davidfriar/the46/case/models/SW_Kailh_Choc_V1.stp

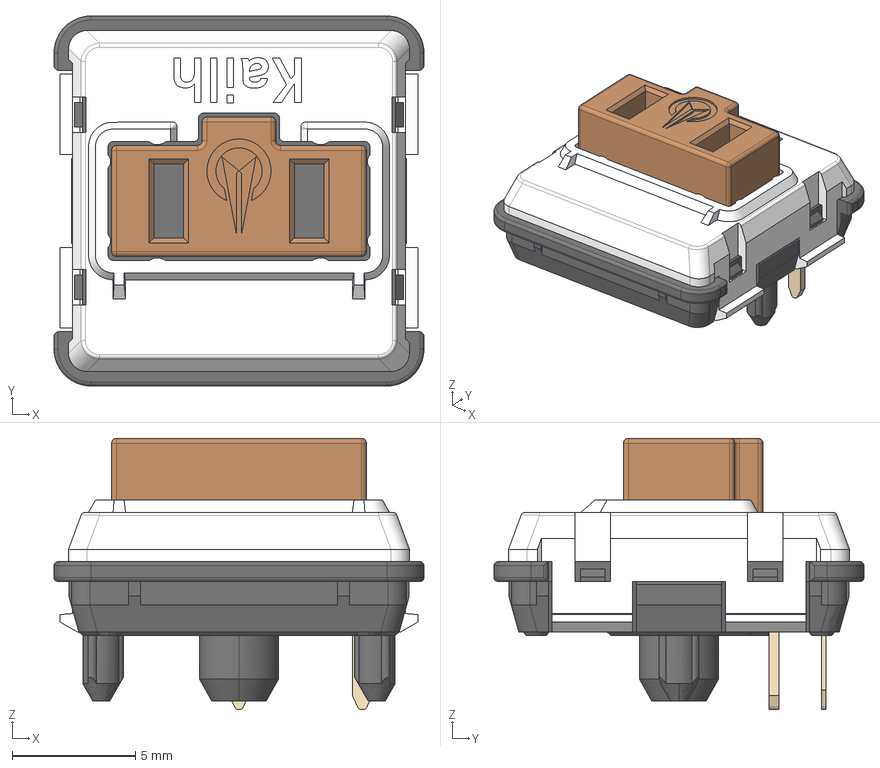
[picture p1: CAD file, 2025-01-09]
case/models/SW_Kailh_Choc_V1.stp
15.0 x 15.0 x 11.0 mm
