davidfriar/the46/ergogen/footprints/niceview.step

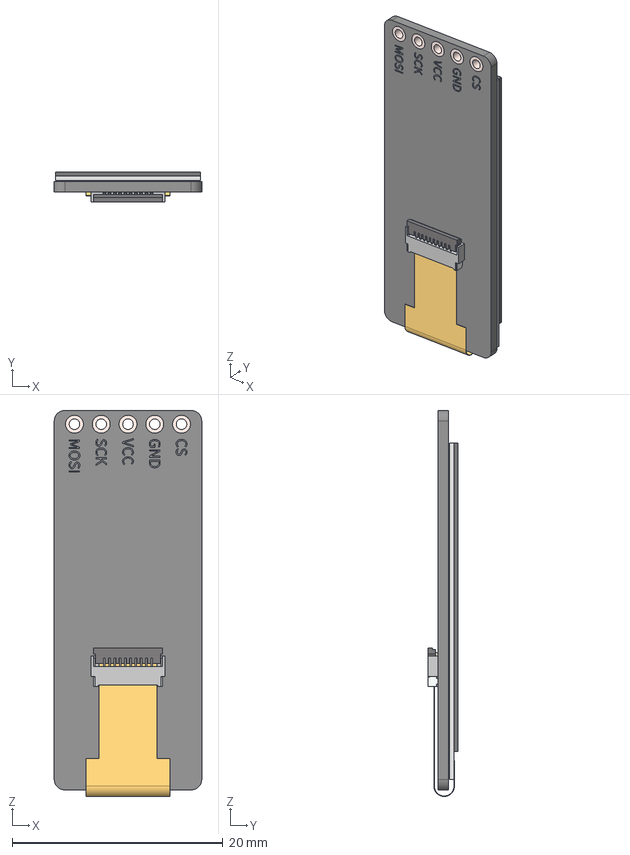
[picture p2: CAD file, 2025-10-15]
ergogen/footprints/niceview.step
14.0 x 2.87 x 36.6 mm
Silkscreen
Screen
FPC
FFC2B28_SP x 2
FFC2B28-10-G_C
FFC2B28-G_P x 10
FFC2B28-10-G_H
FFC2B28-10-G_D
