davidfriar/the46/pcbs/models/S2B-ZR.STEP

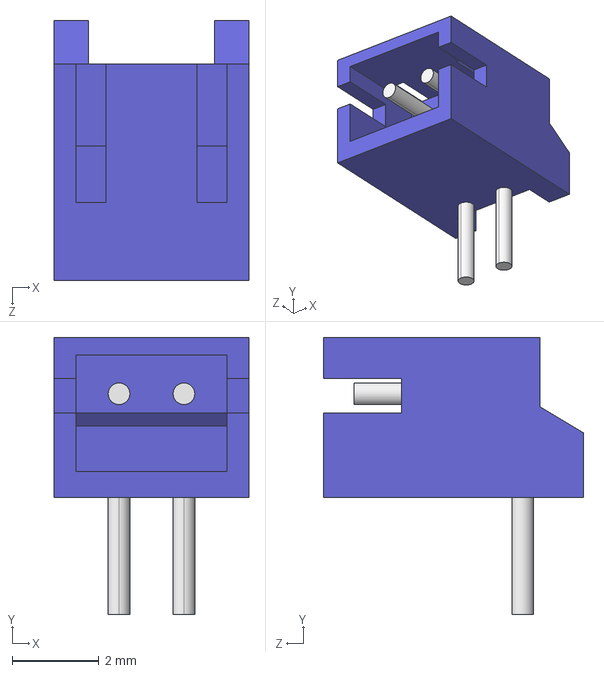
[picture p3: CAD file, 2025-10-15]
pcbs/models/S2B-ZR.STEP
4.50 x 6.40 x 6.00 mm
