davidfriar/the46/ergogen/footprints/FFC2B28-10-G.stp

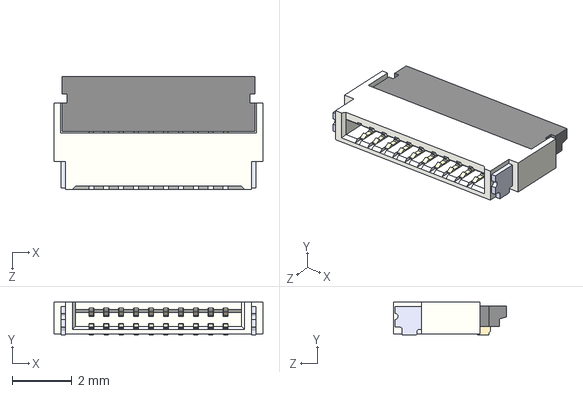
[picture p5: CAD file, 2025-01-09]
ergogen/footprints/FFC2B28-10-G.stp
7.00 x 1.10 x 3.80 mm
