davidfriar/the46/pcbs/models/FFC2B28-12-G.step

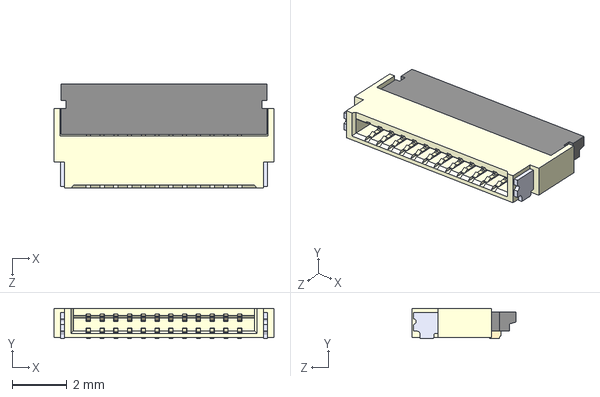
[picture p6: CAD file, 2025-01-09]
pcbs/models/FFC2B28-12-G.step
8.00 x 1.10 x 3.80 mm
