davidfriar/the46/ergogen/footprints/2004850410.stp

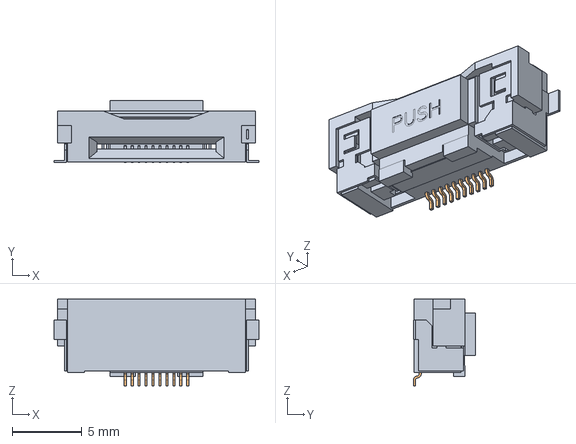
[picture p7: CAD file, 2025-01-09]
ergogen/footprints/2004850410.stp
14.7 x 4.46 x 6.20 mm
