davidfriar/the46/pcbs/models/430471035826_Download_STP_WS-TASV_430471035826_rev1.stp

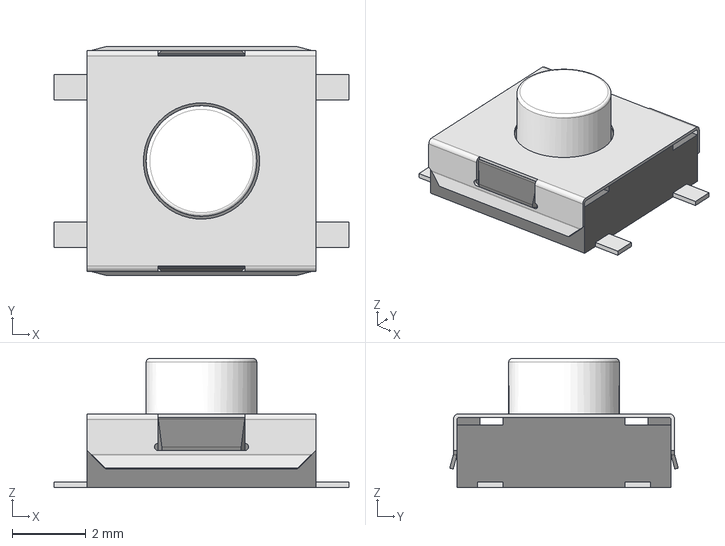
[picture p8: CAD file, 2025-10-15]
pcbs/models/430471035826_Download_STP_WS-TASV_430471035826_rev1.stp
8.00 x 6.20 x 3.50 mm
base
top cover
