davidfriar/the46/pcbs/mainboard/mainboard.kicad_pcb

## KiCad design pcbs/mainboard/mainboard.kicad_pcb (2025-10-22)

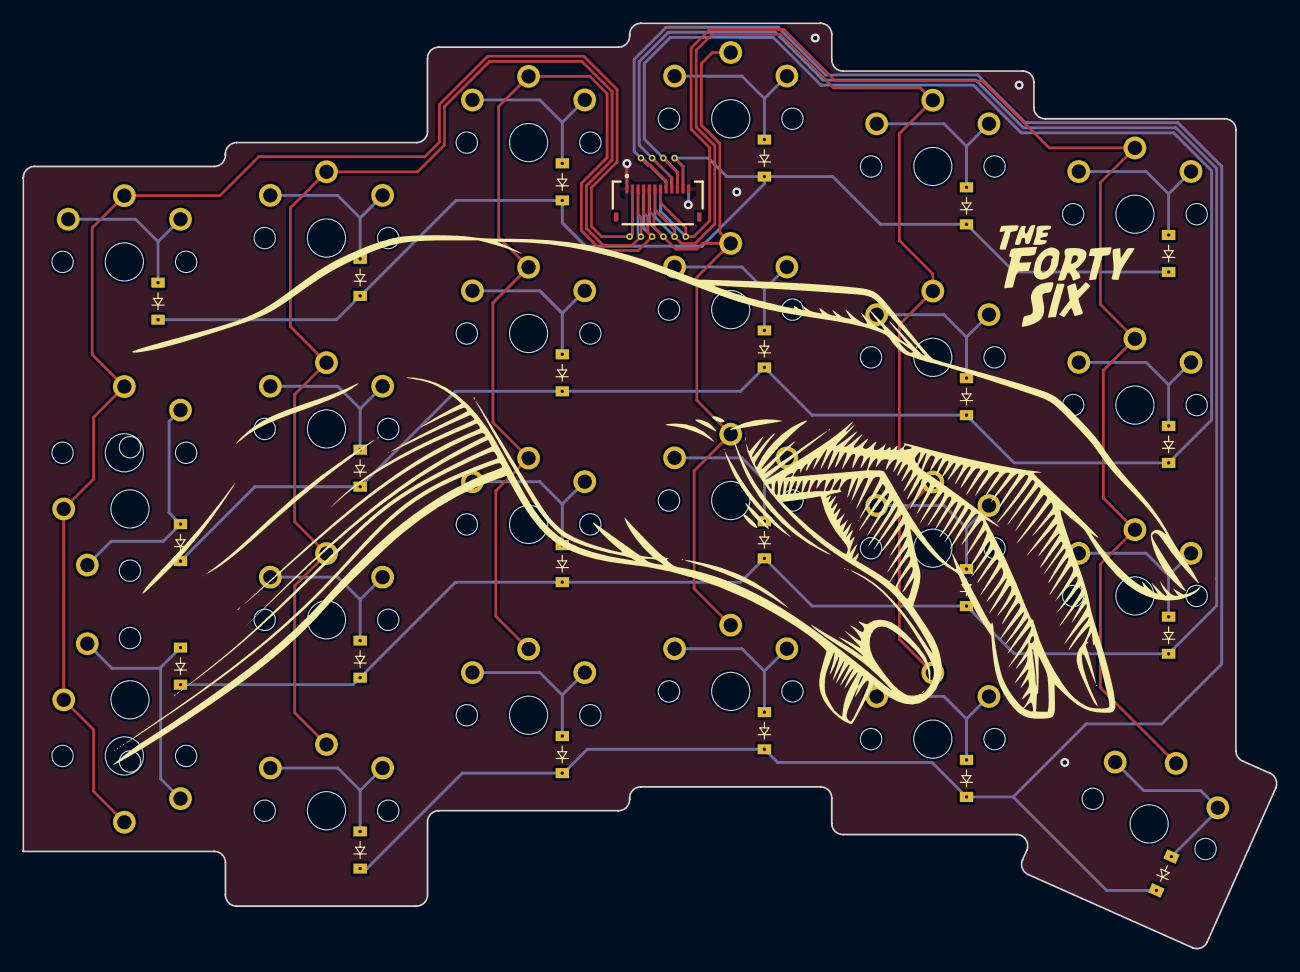
[picture p9: board mainboard.kicad_pcb from above]

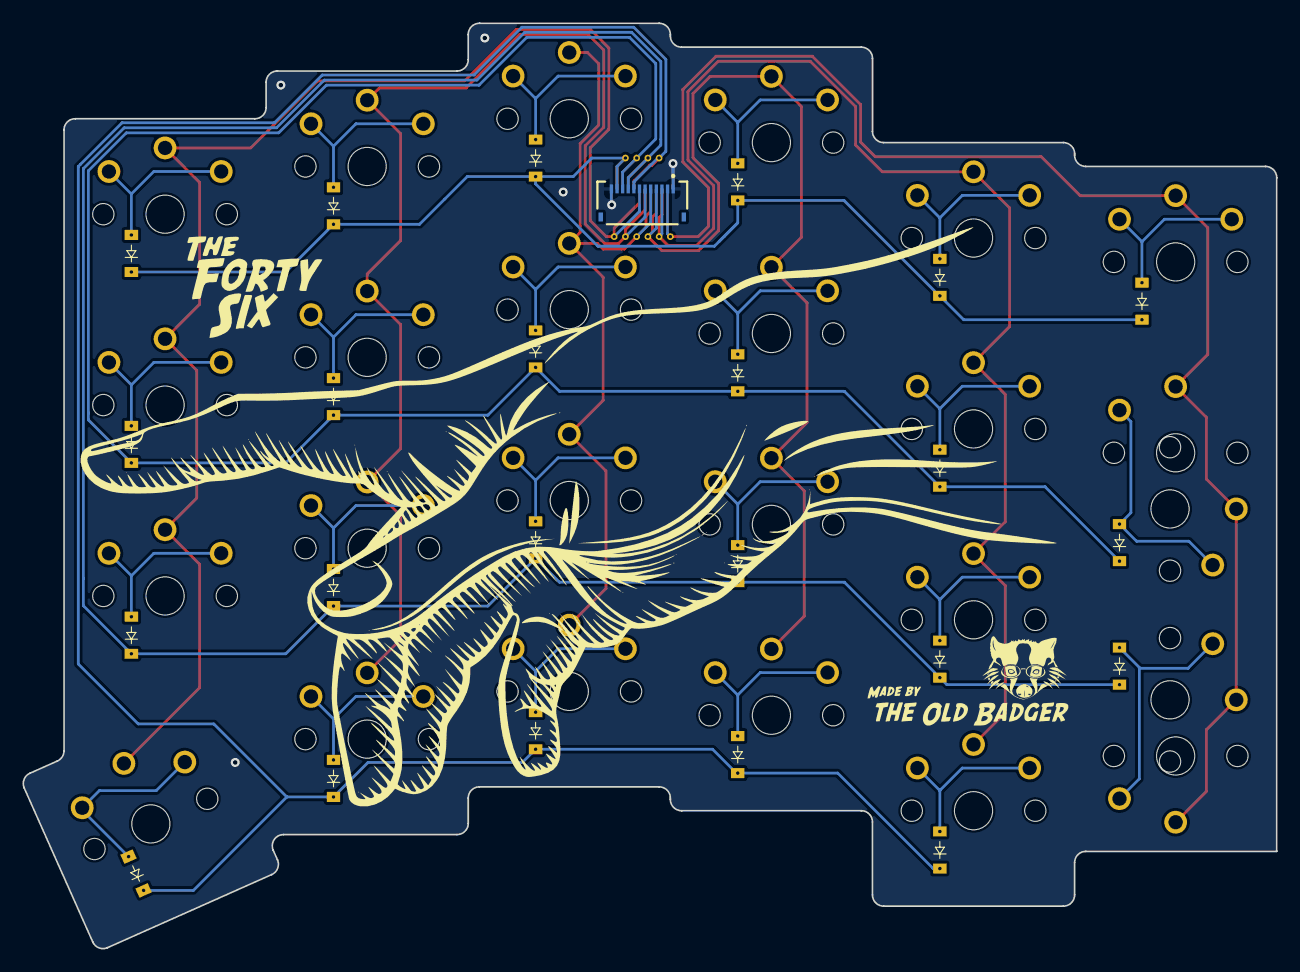
[picture p10: board mainboard.kicad_pcb from below]

Board: 2 copper layers, 111.6 x 82.4 mm, 59 parts (3 on the bottom side), 34 nets.

Parts:
D1, D2, D3, D4, D5, D6, D7, D8, D9, D10, D11, D12, D13, D14, D15, D16, D17, D18, D19, D20, D21, D22, D23: diode_tht_sod123
J1: GCT_FFC2B28-12-G
S1, S2, S3, S4, S5, S6, S7, S8, S9, S10, S11, S12, S13, S14, S15, S16, S17, S18, S19, S20, S21, S22, S23, S24, S25: switch_choc_v1_v2
_1, _2, _3, _4, _5, _6, _7, _8, _9, _10: VIA-0.6mm

Connections:
C1: J1.2, S1.2, S22.2, S23.2, S24.2, S25.2, _1.1
C2: J1.3, S2.2, S3.2, S4.2, S5.2, _2.1
C3: J1.4, S6.2, S7.2, S8.2, S9.2, _3.1
C4: J1.5, S10.2, S11.2, S12.2, S13.2, _4.1
C5: J1.6, S14.2, S15.2, S16.2, S17.2, _5.1
C6: J1.7, S18.2, S19.2, S20.2, S21.2, _6.1
GND: J1.1, J1.12
R1: D2.1, D6.1, D10.1, D14.1, D18.1, J1.8, _7.1
R2: D3.1, D7.1, D11.1, D15.1, D19.1, D23.1, J1.9, _8.1
R3: D4.1, D8.1, D12.1, D16.1, D20.1, D22.1, J1.10, _9.1
R4: D1.1, D5.1, D9.1, D13.1, D17.1, D21.1, J1.11, _10.1
index_bottom: D15.2, S15.1
index_middle: D16.2, S16.1
index_thumb: D14.2, S14.1
index_top: D17.2, S17.1
inner_bottom: D19.2, S19.1
inner_middle: D20.2, S20.1
inner_thumb: D18.2, S18.1
inner_top: D21.2, S21.1
middle_bottom: D11.2, S11.1
middle_middle: D12.2, S12.1
middle_thumb: D10.2, S10.1
middle_top: D13.2, S13.1
outer_bottom: D23.2, S22.1, S24.1
outer_middle: D22.2, S23.1, S25.1
outerleft_top: D1.2, S1.1
pinky_bottom: D3.2, S3.1
pinky_middle: D4.2, S4.1
pinky_thumb: D2.2, S2.1
pinky_top: D5.2, S5.1
ring_bottom: D7.2, S7.1
ring_middle: D8.2, S8.1
ring_thumb: D6.2, S6.1
ring_top: D9.2, S9.1
