davidfriar/the46/pcbs/daughterboard/daughterboard/daughterboard.kicad_pcb

## KiCad design pcbs/daughterboard/daughterboard/daughterboard.kicad_pcb (2025-10-22)

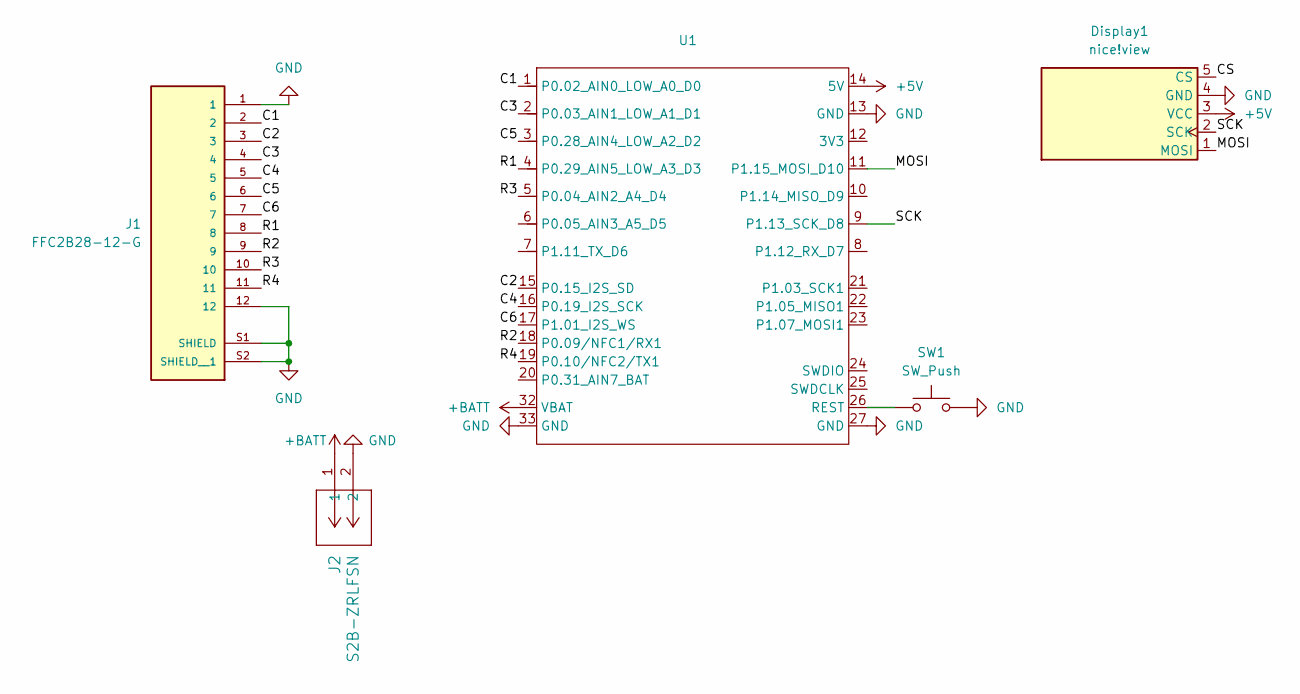
[picture p11: schematic daughterboard.kicad_sch]

Parts:
Display1: nice!view; nice_view
J1: FFC2B28-12-G; GCT_FFC2B28-12-G; PARTREV A
J2: S2B-ZRLFSN; CONN_S2B-ZR_JST
SW1: SW_Push; 430471035826
U1: XIAO-nRF52840-Plus-SMD-updated

Connections:
+5V: Display1.3 (VCC), U1.14 (5V)
+BATT: J2.1, U1.32 (VBAT)
/C1: J1.2, U1.1 (P0.02_AIN0_LOW_A0_D0)
/C2: J1.3, U1.15 (P0.15_I2S_SD)
/C3: J1.4, U1.2 (P0.03_AIN1_LOW_A1_D1)
/C4: J1.5, U1.16 (P0.19_I2S_SCK)
/C5: J1.6, U1.3 (P0.28_AIN4_LOW_A2_D2)
/C6: J1.7, U1.17 (P1.01_I2S_WS)
/CS: Display1.5 (CS), U1.8 (P1.12_RX_D7)
/MOSI: Display1.1 (MOSI), U1.11 (P1.15_MOSI_D10)
/R1: J1.8, U1.4 (P0.29_AIN5_LOW_A3_D3)
/R2: J1.9, U1.18 (P0.09/NFC1/RX1)
/R3: J1.10, U1.5 (P0.04_AIN2_A4_D4)
/R4: J1.11, U1.19 (P0.10/NFC2/TX1)
/SCK: Display1.2 (SCK), U1.9 (P1.13_SCK_D8)
GND: Display1.4 (GND), J1.1, J1.12, J1.S1 (SHIELD), J1.S2 (SHIELD__1), J2.2, SW1.2, U1.13 (GND), U1.27 (GND), U1.33 (GND)
unnamed: SW1.1, U1.26 (REST)

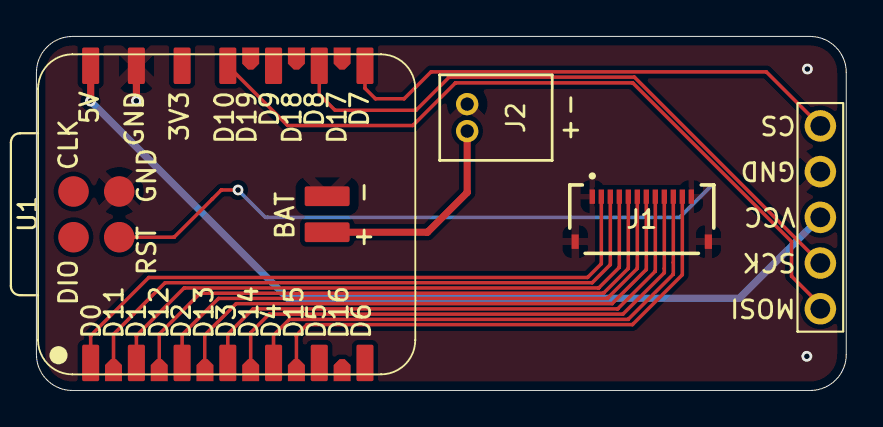
[picture p12: board daughterboard.kicad_pcb from above]

Board: 2 copper layers, 45.0 x 19.7 mm, 5 parts (1 on the bottom side), 17 nets.
