davidfriar/the46/(commit log)

2025-01-10 fix offset etc
    [daughterboard_pcb.step, daughterboard_pcb_dimensions.scad, left-routed.kicad_pcb, left.kicad_pcb, left_pcb.step, left_pcb_dimensions.scad, right-routed.kicad_pcb, right.kicad_pcb]
2025-01-11 exclude stl files
2025-03-02 old changes
    [daughterboard_pcb.step, left.kicad_pcb, left_pcb.step, right.kicad_pcb, right_pcb.step]
2025-09-28 committing old changes
    [case.scad, daughterboard_pcb.step, keys.scad, left.kicad_pcb, right.kicad_pcb]
2025-10-15 lots of changes
    [430471035826_Download_STP_WS-TASV_430471035826_rev1.stp, FFC2B28-12-G.step, S2B-ZR.STEP, XiaoNrf52840plus.step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]
2025-10-19 initial draft of tracking done
    [mainboard.kicad_pcb, mainboard.kicad_sch]
2025-10-22 bodge the fillets to make the plate nice
    [config.yaml]
2025-10-22 final tweaks to pcbs before production
    [daughterboard.kicad_pcb, mainboard.kicad_pcb]
2025-12-31 case updates
    [SW_Kailh_Choc_V1.stp, case.scad, daughterboard.kicad_pcb, daughterboard.kicad_sch, daughterboard_pcb.step, daughterboard_pcb_dimensions.scad, keys.scad, left-routed.kicad_pcb]
2026-01-05 case desigh complete
    [case.scad, keys.scad]
